PUT-Motorsport/PUTM_EV_Dashboard_2021/hardware/Wizualizacja.JPG

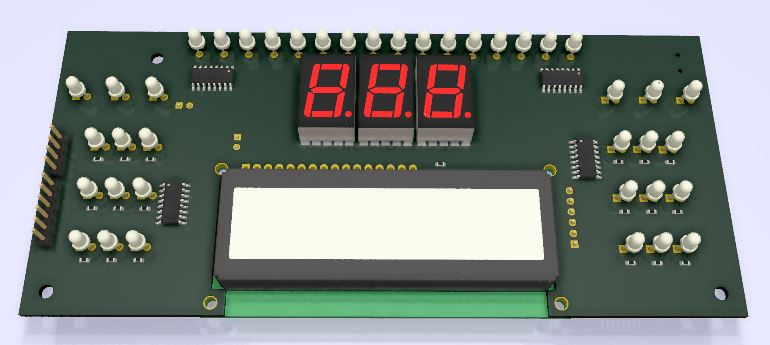
hardware/Wizualizacja.JPG
