PUT-Motorsport/PUTM_EV_Dashboard_2021/hardware/Display2.STEP

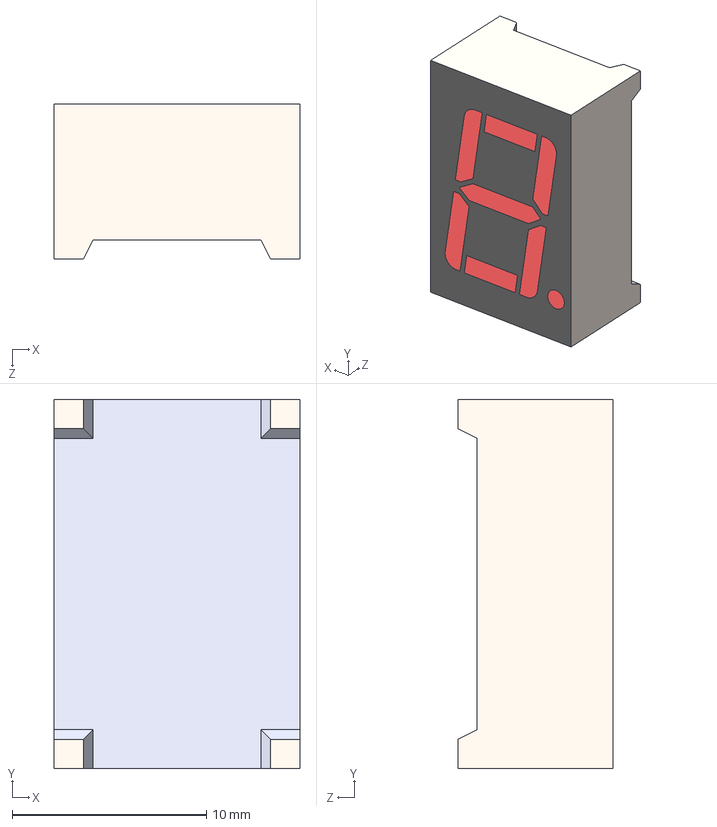
[picture p2: CAD file, 2021-06-22]
hardware/Display2.STEP
12.7 x 19.0 x 8.00 mm
