PUT-Motorsport/PUTM_EV_Dashboard_2021/(list of files, cad)

Other CAD files:
hardware/Display.STEP
hardware/Display.SLDPRT
