PUT-Motorsport/PUTM_EV_Dashboard_2021/hardware/dash_hw.kicad_pcb

## KiCad design hardware/dash_hw.kicad_pcb (2021-06-22)

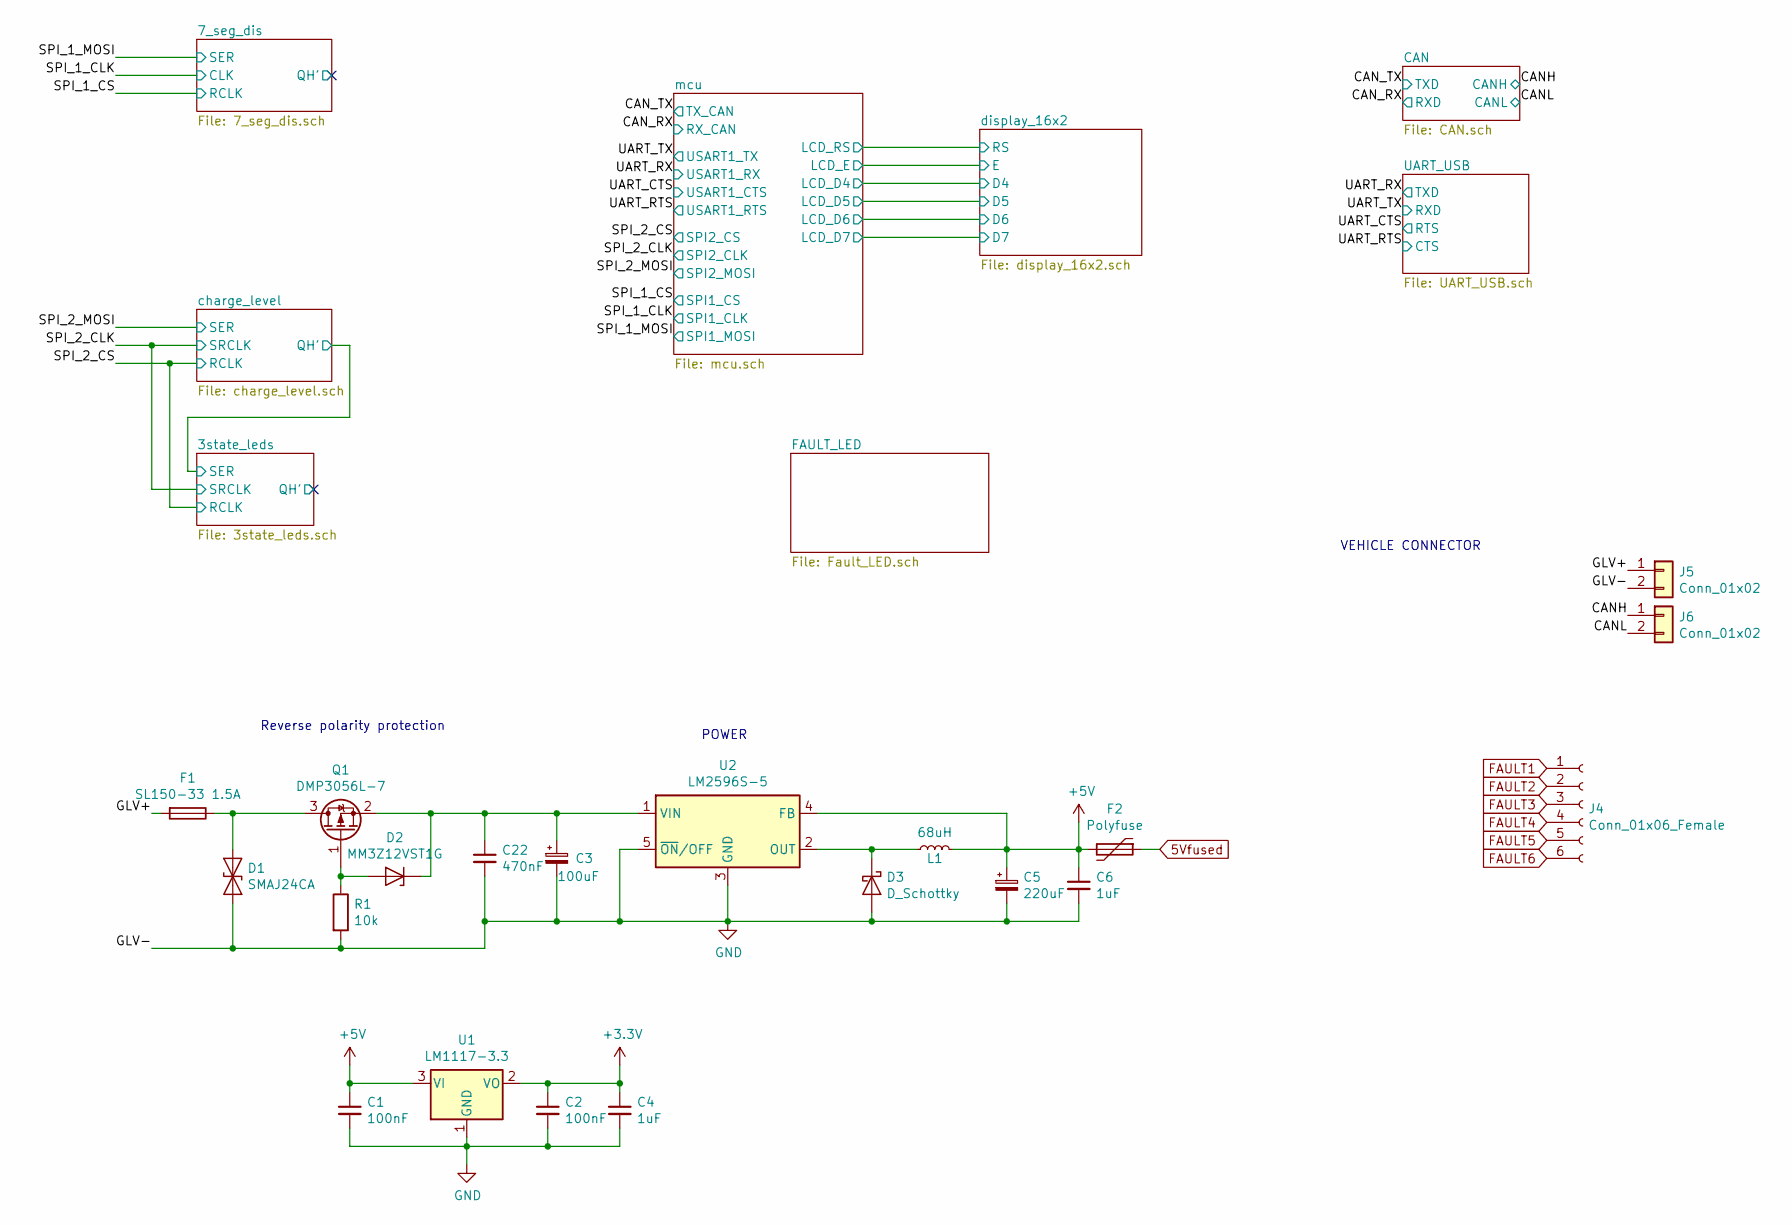
[picture p3: schematic dash_hw.sch, PUTM_EV_Dashboard_2021]

Parts:
C1, C2: 100nF; C_0603_1608Metric
C3: 100uF; CP_Radial_D6.3mm_P2.50mm
C4, C6: 1uF; C_0603_1608Metric
C5: 220uF; CP_Radial_D6.3mm_P2.50mm
C22: 470nF; C_1206_3216Metric
D1: SMAJ24CA; D_SMA
D2: MM3Z12VST1G; D_SOD-323
D3: D_Schottky; D_SMB
F1: SL150-33 1.5A; Fuse_2920_7451Metric
F2: Polyfuse; Fuse_2010_5025Metric
J4: Conn_01x06_Female; PinHeader_1x06_P2.54mm_Vertical
J5, J6: Conn_01x02; PinHeader_1x02_P2.54mm_Vertical
L1: 68uH; L_10.4x10.4_H4.8
Q1: DMP3056L-7; SOT-23
R1: 10k; R_0603_1608Metric
U1: LM1117-3.3; SOT-223-3_TabPin2
U2: LM2596S-5; TO-263-5_TabPin3

Connections:
5Vfused: F2.1; also elsewhere on the board
+3V3: C2.1, C4.1, U1.2 (VO); also elsewhere on the board
+5V: C1.1, C5.1, C6.1, F2.2, L1.2, U1.3 (VI), U2.4 (FB); also elsewhere on the board
/CANH: J6.1; also elsewhere on the board
/CANL: J6.2; also elsewhere on the board
/GLV+: F1.2, J5.1
FAULT1: J4.1; also elsewhere on the board
FAULT2: J4.2; also elsewhere on the board
FAULT3: J4.3; also elsewhere on the board
FAULT4: J4.4; also elsewhere on the board
FAULT5: J4.5; also elsewhere on the board
FAULT6: J4.6; also elsewhere on the board
GND: C1.2, C2.2, C3.2, C4.2, C5.2, C6.2, C22.2, D1.2 (A2), D3.2 (A), J5.2, R1.2, U1.1 (GND), U2.3 (GND), U2.5 (~ON~/OFF); also elsewhere on the board
unnamed: C3.1, C22.1, D2.1 (K), Q1.2 (S), U2.1 (VIN)
unnamed: D1.1 (A1), F1.1, Q1.3 (D)
unnamed: D2.2 (A), Q1.1 (G), R1.1
unnamed: D3.1 (K), L1.1, U2.2 (OUT)

Notes on the sheet:
POWER
Reverse polarity protection
VEHICLE CONNECTOR

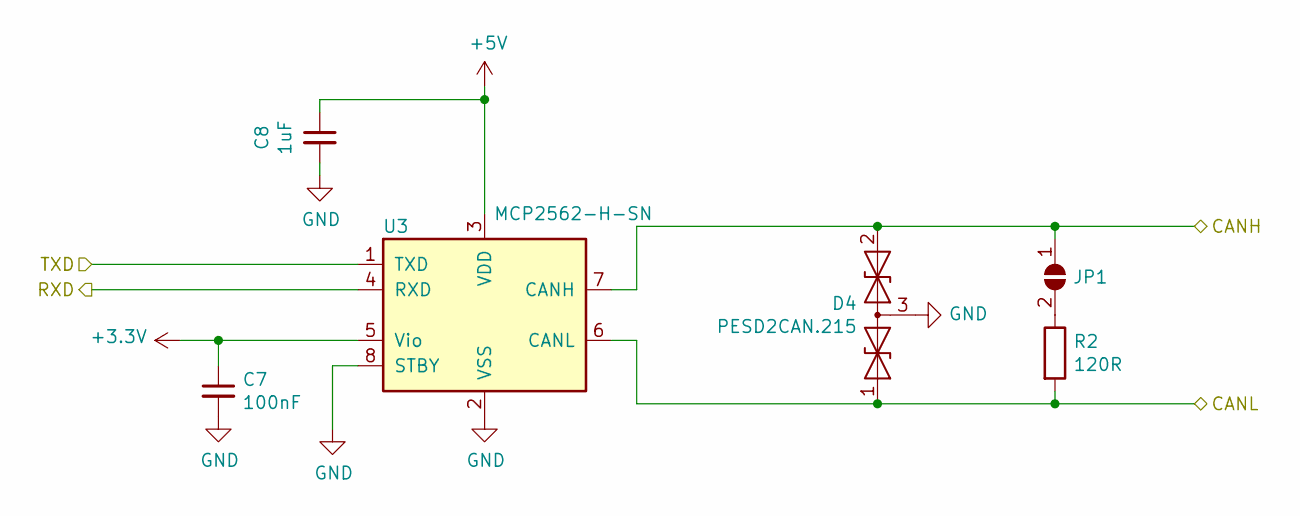
[picture p4: schematic CAN.sch, PUTM_EV_Dashboard_2021]

Parts:
C7: 100nF; C_0603_1608Metric
C8: 1uF; C_0603_1608Metric
D4: PESD2CAN.215; SOT-23
JP1: a; SolderJumper-2_P1.3mm_Open_TrianglePad1.0x1.5mm
R2: 120R; R_0603_1608Metric
U3: MCP2562-H-SN; SOIC-8_3.9x4.9mm_P1.27mm

Connections:
+3V3: C7.1, U3.5 (Vio); also elsewhere on the board
+5V: C8.1, U3.3 (VDD); also elsewhere on the board
/CANH: D4.2 (A2), JP1.1 (A), U3.7 (CANH); also elsewhere on the board
/CANL: D4.1 (A1), R2.2, U3.6 (CANL); also elsewhere on the board
/CAN_RX: U3.4 (RXD); also elsewhere on the board
/CAN_TX: U3.1 (TXD); also elsewhere on the board
GND: C7.2, C8.2, D4.3 (common), U3.2 (VSS), U3.8 (STBY); also elsewhere on the board
unnamed: JP1.2 (B), R2.1

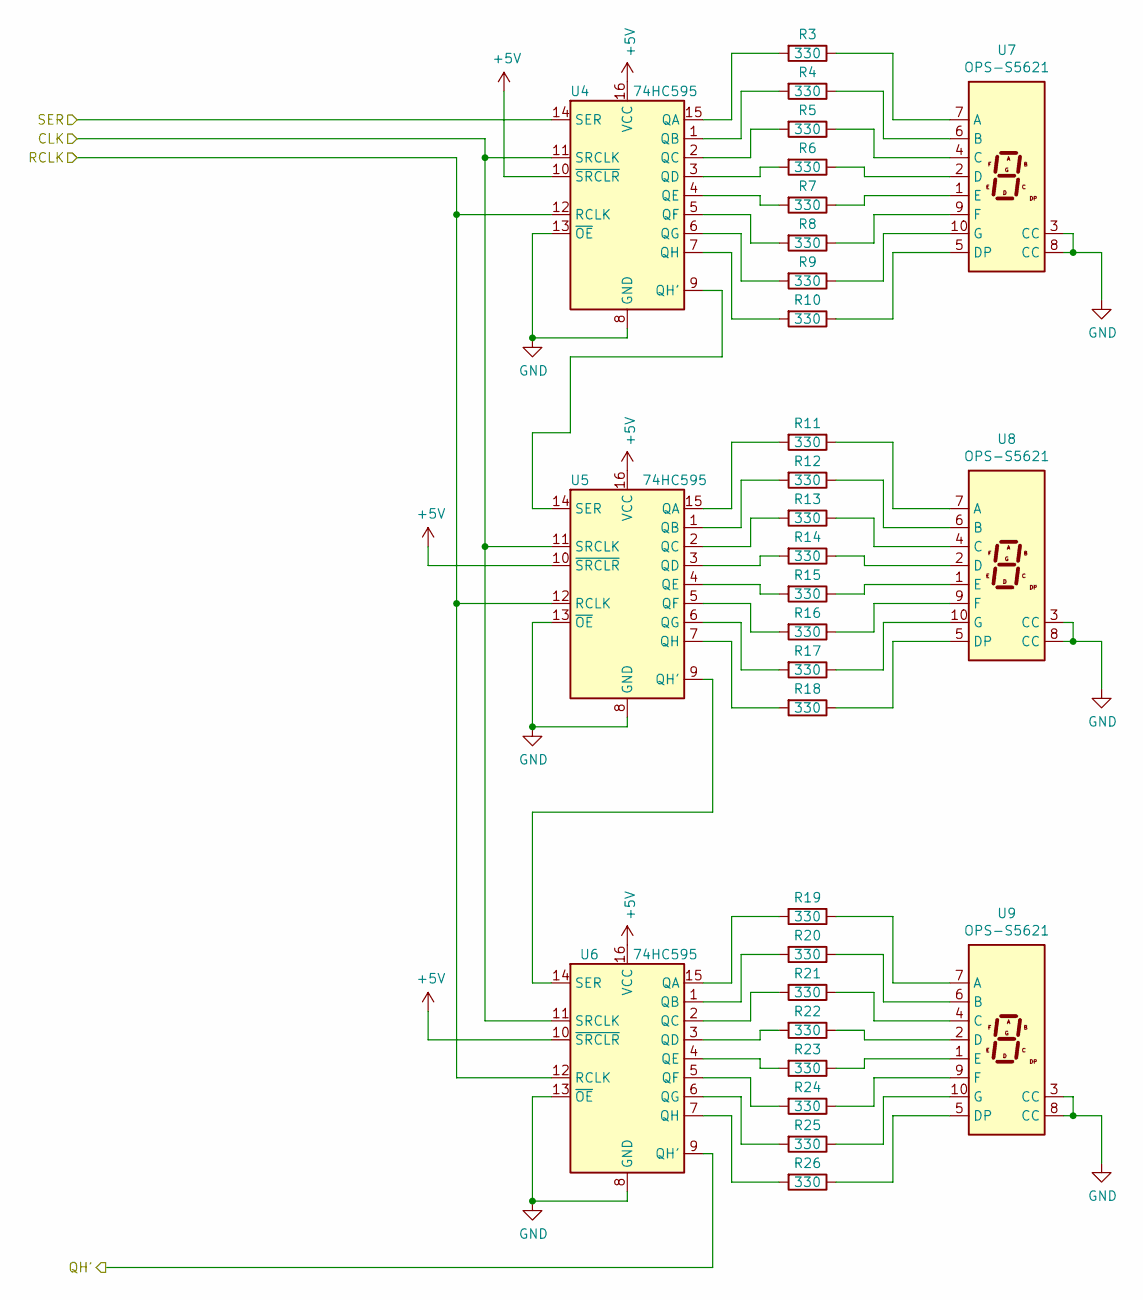
[picture p5: schematic 7_seg_dis.sch, PUTM_EV_Dashboard_2021]

Parts:
R3, R4, R5, R6, R7, R8, R9, R10, R11, R12, R13, R14, R15, R16, R17, R18, R19, R20, R21, R22, R23, R24, R25, R26: 330; R_0603_1608Metric
U4, U5, U6: 74HC595; SOIC-16_3.9x9.9mm_P1.27mm
U7, U8, U9: OPS-S5621; 0.56” Case Mold Type LED Display

Connections:
+5V: U4.10 (~SRCLR), U4.16 (VCC), U5.10 (~SRCLR), U5.16 (VCC), U6.10 (~SRCLR), U6.16 (VCC); also elsewhere on the board
/7_seg_dis/QH': U6.9 (QH')
/SPI_1_CLK: U4.11 (SRCLK), U5.11 (SRCLK), U6.11 (SRCLK); also elsewhere on the board
/SPI_1_CS: U4.12 (RCLK), U5.12 (RCLK), U6.12 (RCLK); also elsewhere on the board
/SPI_1_MOSI: U4.14 (SER); also elsewhere on the board
GND: U4.8 (GND), U4.13 (~OE), U5.8 (GND), U5.13 (~OE), U6.8 (GND), U6.13 (~OE), U7.3 (CC), U7.8 (CC), U8.3 (CC), U8.8 (CC), U9.3 (CC), U9.8 (CC); also elsewhere on the board
unnamed: R3.1, U7.7 (A)
unnamed: R3.2, U4.15 (QA)
unnamed: R4.1, U7.6 (B)
unnamed: R4.2, U4.1 (QB)
unnamed: R5.1, U7.4 (C)
unnamed: R5.2, U4.2 (QC)
unnamed: R6.1, U7.2 (D)
unnamed: R6.2, U4.3 (QD)
unnamed: R7.1, U7.1 (E)
unnamed: R7.2, U4.4 (QE)
unnamed: R8.1, U7.9 (F)
unnamed: R8.2, U4.5 (QF)
unnamed: R9.1, U7.10 (G)
unnamed: R9.2, U4.6 (QG)
unnamed: R10.1, U7.5 (DP)
unnamed: R10.2, U4.7 (QH)
unnamed: R11.1, U8.7 (A)
unnamed: R11.2, U5.15 (QA)
unnamed: R12.1, U8.6 (B)
unnamed: R12.2, U5.1 (QB)
unnamed: R13.1, U8.4 (C)
unnamed: R13.2, U5.2 (QC)
unnamed: R14.1, U8.2 (D)
unnamed: R14.2, U5.3 (QD)
unnamed: R15.1, U8.1 (E)
unnamed: R15.2, U5.4 (QE)
unnamed: R16.1, U8.9 (F)
unnamed: R16.2, U5.5 (QF)
unnamed: R17.1, U8.10 (G)
unnamed: R17.2, U5.6 (QG)
unnamed: R18.1, U8.5 (DP)
unnamed: R18.2, U5.7 (QH)
unnamed: R19.1, U9.7 (A)
unnamed: R19.2, U6.15 (QA)
unnamed: R20.1, U9.6 (B)
unnamed: R20.2, U6.1 (QB)
unnamed: R21.1, U9.4 (C)
unnamed: R21.2, U6.2 (QC)
unnamed: R22.1, U9.2 (D)
unnamed: R22.2, U6.3 (QD)
unnamed: R23.1, U9.1 (E)
unnamed: R23.2, U6.4 (QE)
unnamed: R24.1, U9.9 (F)
unnamed: R24.2, U6.5 (QF)
unnamed: R25.1, U9.10 (G)
unnamed: R25.2, U6.6 (QG)
unnamed: R26.1, U9.5 (DP)
unnamed: R26.2, U6.7 (QH)
unnamed: U4.9 (QH'), U5.14 (SER)
unnamed: U5.9 (QH'), U6.14 (SER)

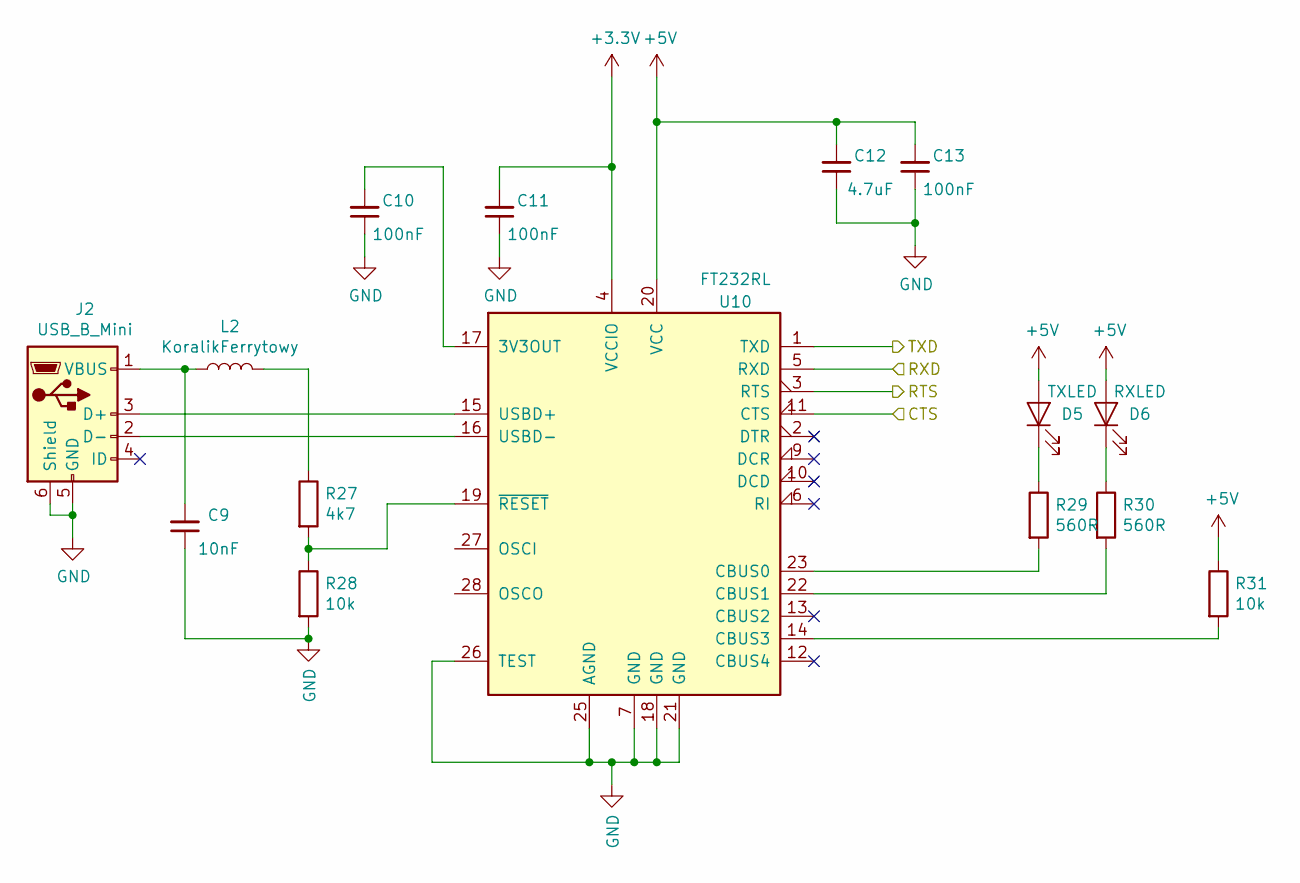
[picture p6: schematic UART_USB.sch, PUTM_EV_Dashboard_2021]

Parts:
C9: 10nF; C_0603_1608Metric
C10, C11, C13: 100nF; C_0603_1608Metric
C12: 4.7uF; C_0603_1608Metric
D5: TXLED; LED_0603_1608Metric
D6: RXLED; LED_0603_1608Metric
J2: USB_B_Mini; USB_Mini-B_Lumberg_2486_01_Horizontal
L2: KoralikFerrytowy; L_0603_1608Metric
R27: 4k7; R_0603_1608Metric
R28, R31: 10k; R_0603_1608Metric
R29, R30: 560R; R_0603_1608Metric
U10: FT232RL; SSOP-28_5.3x10.2mm_P0.65mm

Connections:
+3V3: C11.2, U10.4 (VCCIO); also elsewhere on the board
+5V: C12.2, C13.2, D5.2 (A), D6.2 (A), R31.1, U10.20 (VCC); also elsewhere on the board
/UART_CTS: U10.3 (RTS); also elsewhere on the board
/UART_RTS: U10.11 (CTS); also elsewhere on the board
/UART_RX: U10.1 (TXD); also elsewhere on the board
/UART_TX: U10.5 (RXD); also elsewhere on the board
GND: C9.1, C10.1, C11.1, C12.1, C13.1, J2.5 (GND), J2.6 (Shield), R28.2, U10.7 (GND), U10.18 (GND), U10.21 (GND), U10.25 (AGND), U10.26 (TEST); also elsewhere on the board
unnamed: C9.2, J2.1 (VBUS), L2.1
unnamed: C10.2, U10.17 (3V3OUT)
unnamed: D5.1 (K), R29.1
unnamed: D6.1 (K), R30.1
unnamed: J2.2 (D-), U10.16 (USBD-)
unnamed: J2.3 (D+), U10.15 (USBD+)
unnamed: L2.2, R27.1
unnamed: R27.2, R28.1, U10.19 (~RESET~)
unnamed: R29.2, U10.23 (CBUS0)
unnamed: R30.2, U10.22 (CBUS1)
unnamed: R31.2, U10.14 (CBUS3)

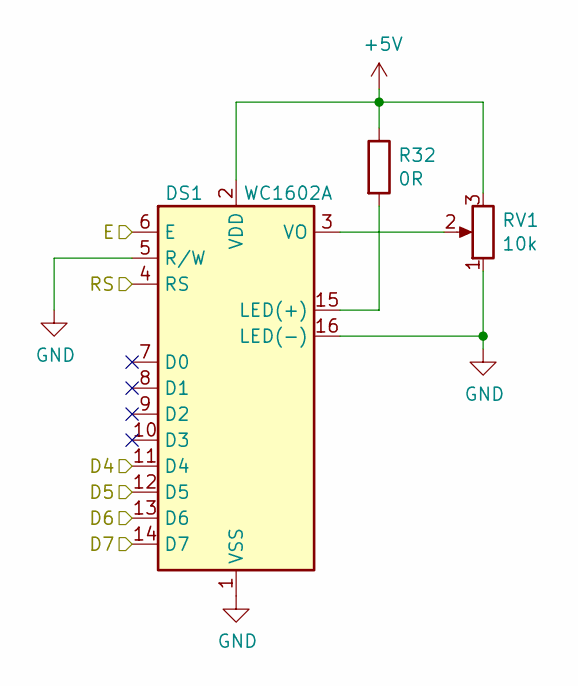
[picture p7: schematic display_16x2.sch, PUTM_EV_Dashboard_2021]

Parts:
DS1: WC1602A
R32: 0R; R_0603_1608Metric
RV1: 10k; Potentiometer_Vishay_TS53YJ_Vertical

Connections:
+5V: DS1.2 (VDD), R32.1, RV1.3; also elsewhere on the board
/display_16x2/D4: DS1.11 (D4); also elsewhere on the board
/display_16x2/D5: DS1.12 (D5); also elsewhere on the board
/display_16x2/D6: DS1.13 (D6); also elsewhere on the board
/display_16x2/D7: DS1.14 (D7); also elsewhere on the board
/display_16x2/E: DS1.6 (E); also elsewhere on the board
/mcu/LCD_RS: DS1.4 (RS); also elsewhere on the board
GND: DS1.1 (VSS), DS1.5 (R/W), DS1.16 (LED(-)), RV1.1; also elsewhere on the board
unnamed: DS1.3 (VO), RV1.2
unnamed: DS1.15 (LED(+)), R32.2

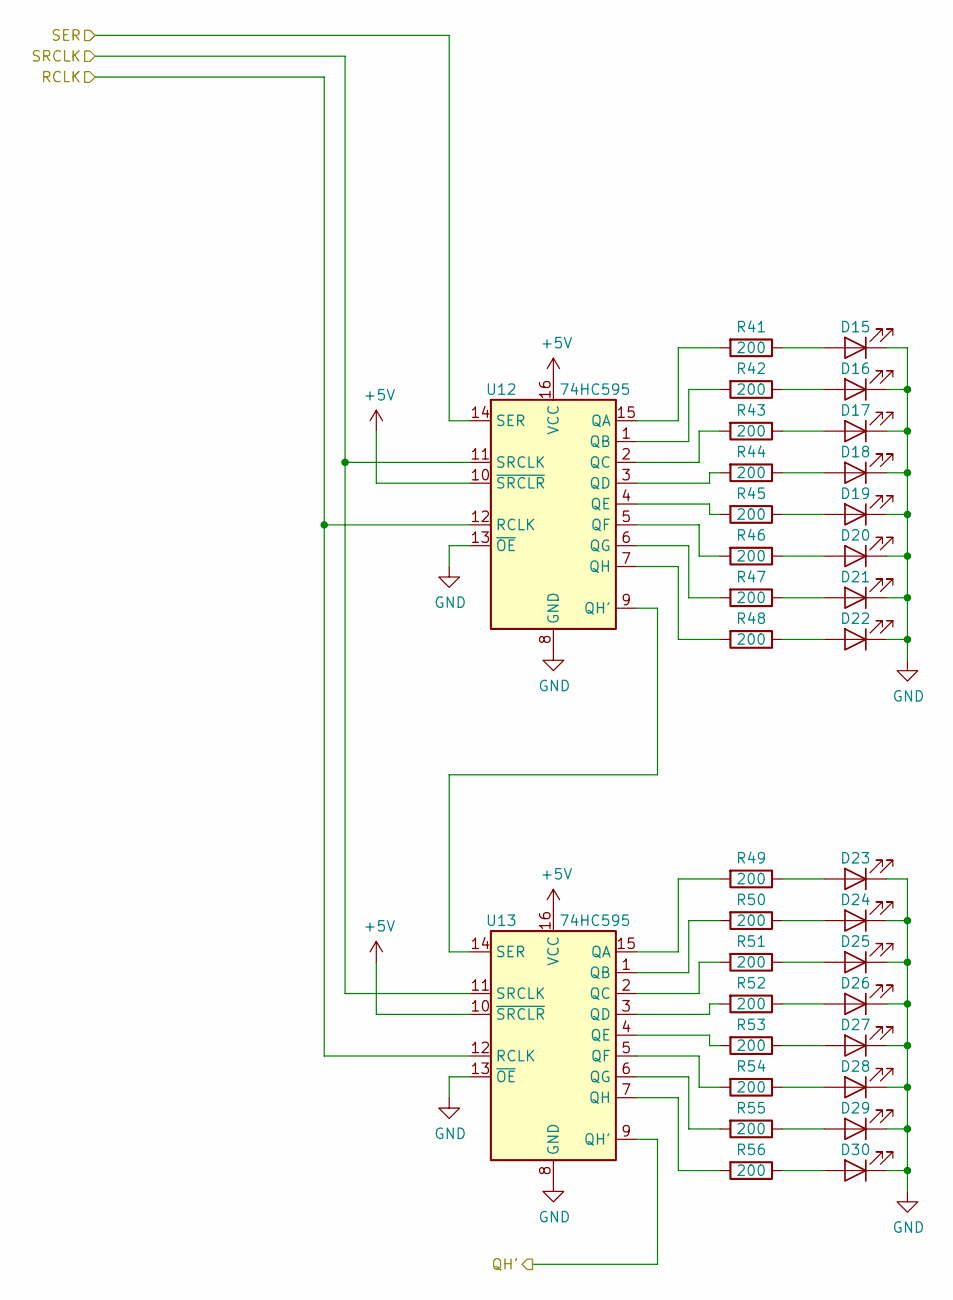
[picture p8: schematic charge_level.sch]

Parts:
D15, D16, D17, D18, D19, D20, D21, D22, D23, D24, D25, D26, D27, D28, D29, D30: LED; LED_D3.0mm_Clear
R41, R42, R43, R44, R45, R46, R47, R48, R49, R50, R51, R52, R53, R54, R55, R56: 200; R_0603_1608Metric
U12, U13: 74HC595; SOIC-16_3.9x9.9mm_P1.27mm

Connections:
+5V: U12.10 (~SRCLR), U12.16 (VCC), U13.10 (~SRCLR), U13.16 (VCC); also elsewhere on the board
/SPI_2_CLK: U12.11 (SRCLK), U13.11 (SRCLK); also elsewhere on the board
/SPI_2_CS: U12.12 (RCLK), U13.12 (RCLK); also elsewhere on the board
/SPI_2_MOSI: U12.14 (SER); also elsewhere on the board
/charge_level/QH': U13.9 (QH'); also elsewhere on the board
GND: D15.1 (K), D16.1 (K), D17.1 (K), D18.1 (K), D19.1 (K), D20.1 (K), D21.1 (K), D22.1 (K), D23.1 (K), D24.1 (K), D25.1 (K), D26.1 (K), D27.1 (K), D28.1 (K), D29.1 (K), D30.1 (K), U12.8 (GND), U12.13 (~OE), U13.8 (GND), U13.13 (~OE); also elsewhere on the board
unnamed: D15.2 (A), R41.1
unnamed: D16.2 (A), R42.1
unnamed: D17.2 (A), R43.1
unnamed: D18.2 (A), R44.1
unnamed: D19.2 (A), R45.1
unnamed: D20.2 (A), R46.1
unnamed: D21.2 (A), R47.1
unnamed: D22.2 (A), R48.1
unnamed: D23.2 (A), R49.1
unnamed: D24.2 (A), R50.1
unnamed: D25.2 (A), R51.1
unnamed: D26.2 (A), R52.1
unnamed: D27.2 (A), R53.1
unnamed: D28.2 (A), R54.1
unnamed: D29.2 (A), R55.1
unnamed: D30.2 (A), R56.1
unnamed: R41.2, U12.15 (QA)
unnamed: R42.2, U12.1 (QB)
unnamed: R43.2, U12.2 (QC)
unnamed: R44.2, U12.3 (QD)
unnamed: R45.2, U12.4 (QE)
unnamed: R46.2, U12.5 (QF)
unnamed: R47.2, U12.6 (QG)
unnamed: R48.2, U12.7 (QH)
unnamed: R49.2, U13.15 (QA)
unnamed: R50.2, U13.1 (QB)
unnamed: R51.2, U13.2 (QC)
unnamed: R52.2, U13.3 (QD)
unnamed: R53.2, U13.4 (QE)
unnamed: R54.2, U13.5 (QF)
unnamed: R55.2, U13.6 (QG)
unnamed: R56.2, U13.7 (QH)
unnamed: U12.9 (QH'), U13.14 (SER)

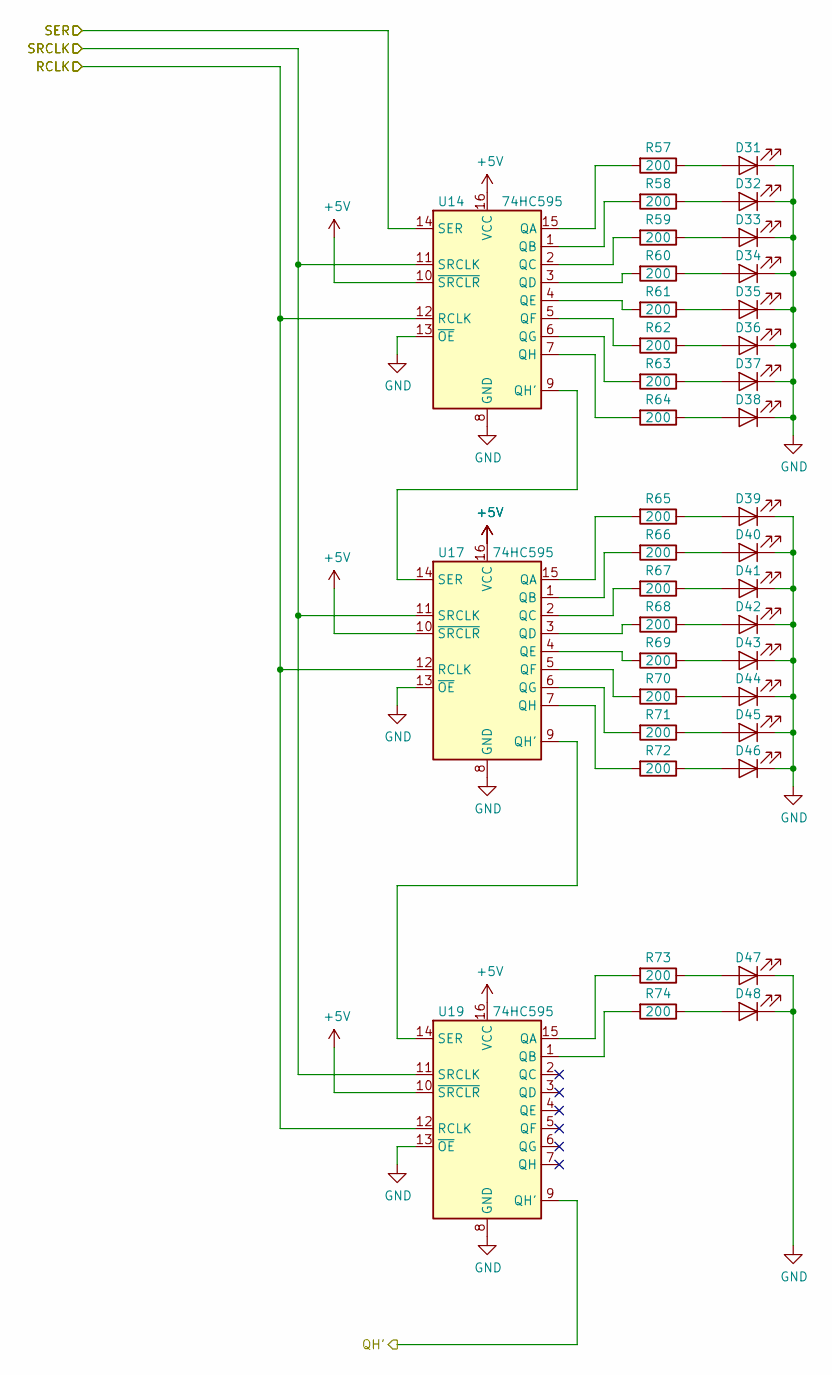
[picture p9: schematic 3state_leds.sch, PUTM_EV_Dashboard_2021]

Parts:
D31, D32, D33, D34, D35, D36, D37, D38, D39, D40, D41, D42, D43, D44, D45, D46, D47, D48: LED; LED_D3.0mm_Clear
R57, R58, R59, R60, R61, R62, R63, R64, R65, R66, R67, R68, R69, R70, R71, R72, R73, R74: 200; R_0603_1608Metric
U14, U17, U19: 74HC595; SOIC-16_3.9x9.9mm_P1.27mm

Connections:
+5V: U14.10 (~SRCLR), U14.16 (VCC), U17.10 (~SRCLR), U17.16 (VCC), U19.10 (~SRCLR), U19.16 (VCC); also elsewhere on the board
/3state_leds/QH': U19.9 (QH')
/SPI_2_CLK: U14.11 (SRCLK), U17.11 (SRCLK), U19.11 (SRCLK); also elsewhere on the board
/SPI_2_CS: U14.12 (RCLK), U17.12 (RCLK), U19.12 (RCLK); also elsewhere on the board
/charge_level/QH': U14.14 (SER); also elsewhere on the board
GND: D31.1 (K), D32.1 (K), D33.1 (K), D34.1 (K), D35.1 (K), D36.1 (K), D37.1 (K), D38.1 (K), D39.1 (K), D40.1 (K), D41.1 (K), D42.1 (K), D43.1 (K), D44.1 (K), D45.1 (K), D46.1 (K), D47.1 (K), D48.1 (K), U14.8 (GND), U14.13 (~OE), U17.8 (GND), U17.13 (~OE), U19.8 (GND), U19.13 (~OE); also elsewhere on the board
unnamed: D31.2 (A), R57.1
unnamed: D32.2 (A), R58.1
unnamed: D33.2 (A), R59.1
unnamed: D34.2 (A), R60.1
unnamed: D35.2 (A), R61.1
unnamed: D36.2 (A), R62.1
unnamed: D37.2 (A), R63.1
unnamed: D38.2 (A), R64.1
unnamed: D39.2 (A), R65.1
unnamed: D40.2 (A), R66.1
unnamed: D41.2 (A), R67.1
unnamed: D42.2 (A), R68.1
unnamed: D43.2 (A), R69.1
unnamed: D44.2 (A), R70.1
unnamed: D45.2 (A), R71.1
unnamed: D46.2 (A), R72.1
unnamed: D47.2 (A), R73.1
unnamed: D48.2 (A), R74.1
unnamed: R57.2, U14.15 (QA)
unnamed: R58.2, U14.1 (QB)
unnamed: R59.2, U14.2 (QC)
unnamed: R60.2, U14.3 (QD)
unnamed: R61.2, U14.4 (QE)
unnamed: R62.2, U14.5 (QF)
unnamed: R63.2, U14.6 (QG)
unnamed: R64.2, U14.7 (QH)
unnamed: R65.2, U17.15 (QA)
unnamed: R66.2, U17.1 (QB)
unnamed: R67.2, U17.2 (QC)
unnamed: R68.2, U17.3 (QD)
unnamed: R69.2, U17.4 (QE)
unnamed: R70.2, U17.5 (QF)
unnamed: R71.2, U17.6 (QG)
unnamed: R72.2, U17.7 (QH)
unnamed: R73.2, U19.15 (QA)
unnamed: R74.2, U19.1 (QB)
unnamed: U14.9 (QH'), U17.14 (SER)
unnamed: U17.9 (QH'), U19.14 (SER)

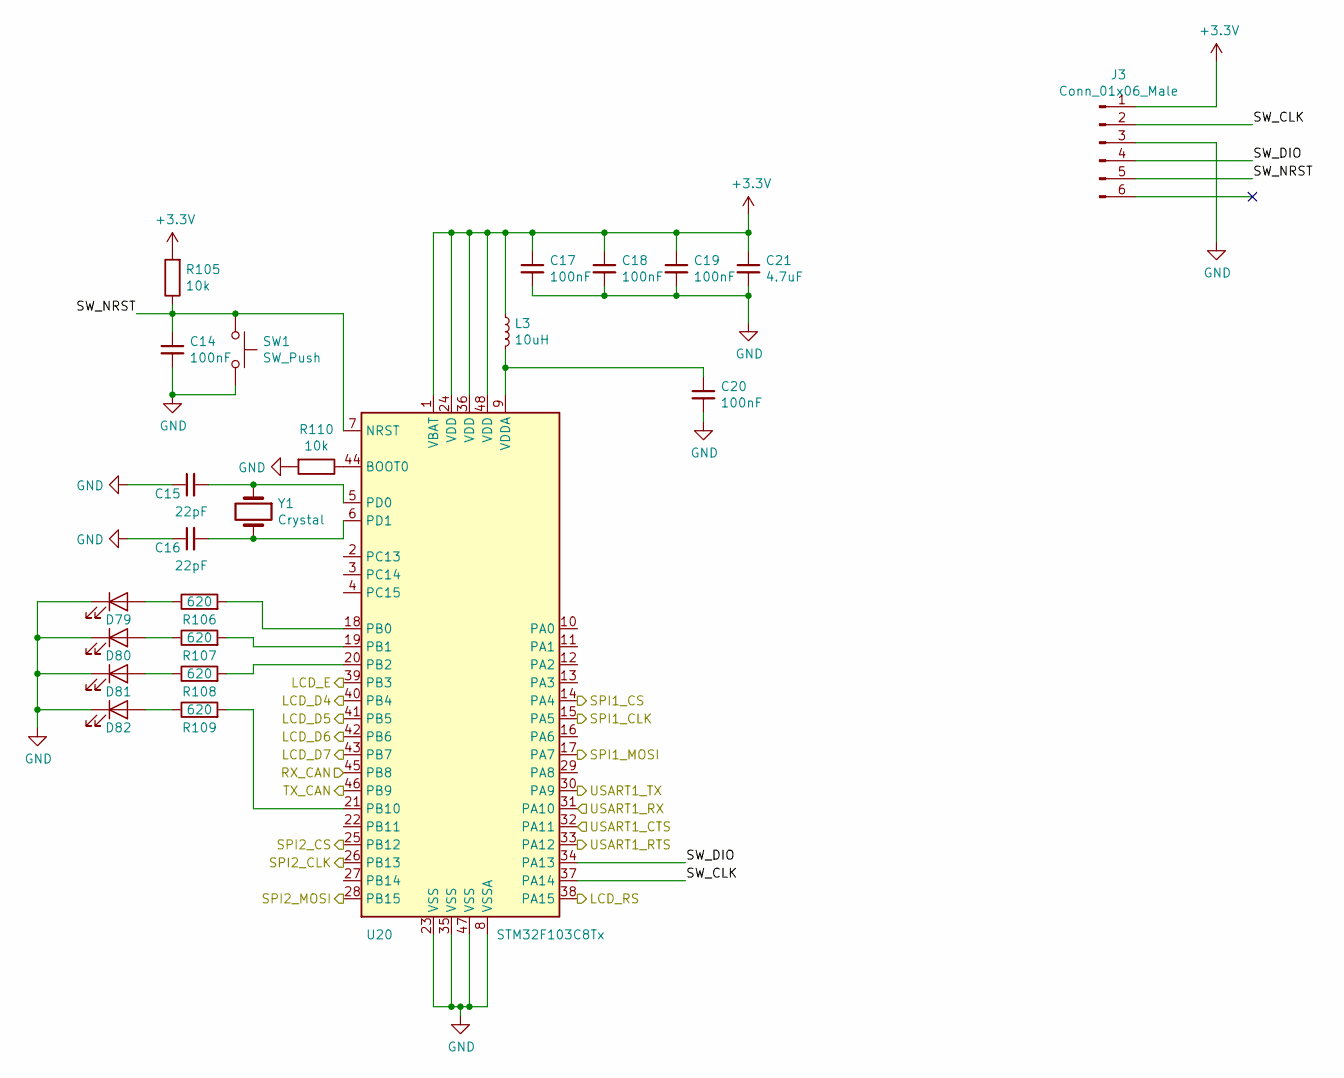
[picture p10: schematic mcu.sch]

Parts:
C14, C17, C18, C19, C20: 100nF; C_0603_1608Metric
C15, C16: 22pF; C_0603_1608Metric
C21: 4.7uF; C_0603_1608Metric
D79, D80, D81, D82: LED; LED_0603_1608Metric
J3: Conn_01x06_Male; PinHeader_1x06_P2.54mm_Vertical
L3: 10uH; L_0603_1608Metric
R105, R110: 10k; R_0603_1608Metric
R106, R107, R108, R109: 620; R_0603_1608Metric
SW1: SW_Push; SW_Push_1P1T_NO_6x6mm_H9.5mm
U20: STM32F103C8Tx; LQFP-48_7x7mm_P0.5mm
Y1: Crystal; Crystal_SMD_HC49-SD

Connections:
+3V3: C17.1, C18.1, C19.1, C21.1, J3.1, L3.1, R105.2, U20.1 (VBAT), U20.24 (VDD), U20.36 (VDD), U20.48 (VDD); also elsewhere on the board
/CAN_RX: U20.45 (PB8); also elsewhere on the board
/CAN_TX: U20.46 (PB9); also elsewhere on the board
/SPI_1_CLK: U20.15 (PA5); also elsewhere on the board
/SPI_1_CS: U20.14 (PA4); also elsewhere on the board
/SPI_1_MOSI: U20.17 (PA7); also elsewhere on the board
/SPI_2_CLK: U20.26 (PB13); also elsewhere on the board
/SPI_2_CS: U20.25 (PB12); also elsewhere on the board
/SPI_2_MOSI: U20.28 (PB15); also elsewhere on the board
/UART_CTS: U20.32 (PA11); also elsewhere on the board
/UART_RTS: U20.33 (PA12); also elsewhere on the board
/UART_RX: U20.31 (PA10); also elsewhere on the board
/UART_TX: U20.30 (PA9); also elsewhere on the board
/display_16x2/D4: U20.40 (PB4); also elsewhere on the board
/display_16x2/D5: U20.41 (PB5); also elsewhere on the board
/display_16x2/D6: U20.42 (PB6); also elsewhere on the board
/display_16x2/D7: U20.43 (PB7); also elsewhere on the board
/display_16x2/E: U20.39 (PB3); also elsewhere on the board
/mcu/LCD_RS: U20.38 (PA15); also elsewhere on the board
/mcu/SW_CLK: J3.2, U20.37 (PA14)
/mcu/SW_DIO: J3.4, U20.34 (PA13)
/mcu/SW_NRST: C14.1, J3.5, R105.1, SW1.1, U20.7 (NRST)
GND: C14.2, C15.1, C16.1, C17.2, C18.2, C19.2, C20.2, C21.2, D79.1 (K), D80.1 (K), D81.1 (K), D82.1 (K), J3.3, R110.2, SW1.2, U20.8 (VSSA), U20.23 (VSS), U20.35 (VSS), U20.47 (VSS); also elsewhere on the board
unnamed: C15.2, U20.5 (PD0), Y1.1
unnamed: C16.2, U20.6 (PD1), Y1.2
unnamed: C20.1, L3.2, U20.9 (VDDA)
unnamed: D79.2 (A), R106.1
unnamed: D80.2 (A), R107.1
unnamed: D81.2 (A), R108.1
unnamed: D82.2 (A), R109.1
unnamed: R106.2, U20.18 (PB0)
unnamed: R107.2, U20.19 (PB1)
unnamed: R108.2, U20.20 (PB2)
unnamed: R109.2, U20.21 (PB10)
unnamed: R110.1, U20.44 (BOOT0)

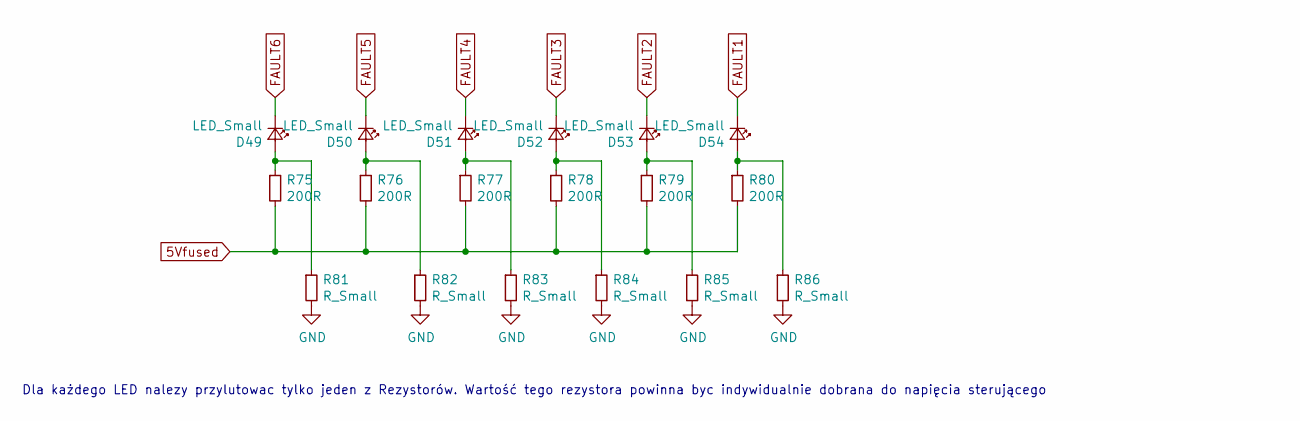
[picture p11: schematic Fault_LED.sch]

Parts:
D49, D50, D51, D52, D53, D54: LED_Small; LED_D3.0mm_Clear
R75, R76, R77, R78, R79, R80: 200R; C_0603_1608Metric
R81, R82, R83, R84, R85, R86: R_Small; C_0603_1608Metric

Connections:
5Vfused: R75.2, R76.2, R77.2, R78.2, R79.2, R80.2; also elsewhere on the board
FAULT1: D54.1 (K); also elsewhere on the board
FAULT2: D53.1 (K); also elsewhere on the board
FAULT3: D52.1 (K); also elsewhere on the board
FAULT4: D51.1 (K); also elsewhere on the board
FAULT5: D50.1 (K); also elsewhere on the board
FAULT6: D49.1 (K); also elsewhere on the board
GND: R81.2, R82.2, R83.2, R84.2, R85.2, R86.2; also elsewhere on the board
unnamed: D49.2 (A), R75.1, R81.1
unnamed: D50.2 (A), R76.1, R82.1
unnamed: D51.2 (A), R77.1, R83.1
unnamed: D52.2 (A), R78.1, R84.1
unnamed: D53.2 (A), R79.1, R85.1
unnamed: D54.2 (A), R80.1, R86.1

Notes on the sheet:
Dla każdego LED nalezy przylutowac tylko jeden z Rezystorów. Wartość tego rezystora powinna byc indywidualnie dobrana do napięcia sterującego

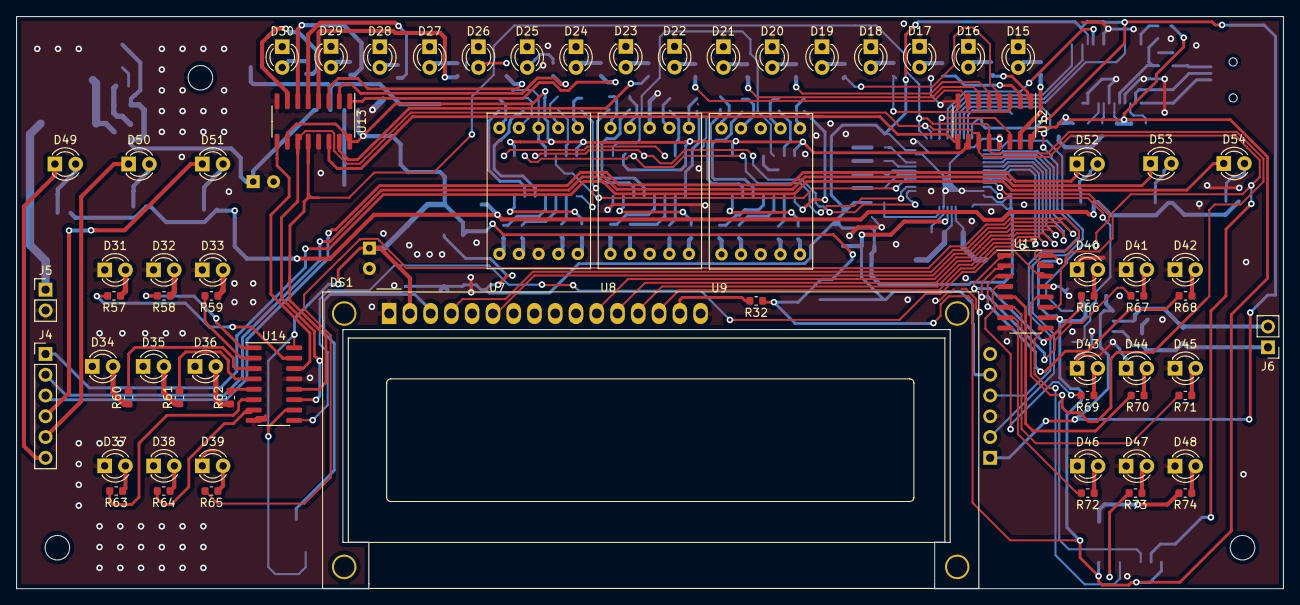
[picture p12: board dash_hw.kicad_pcb from above]

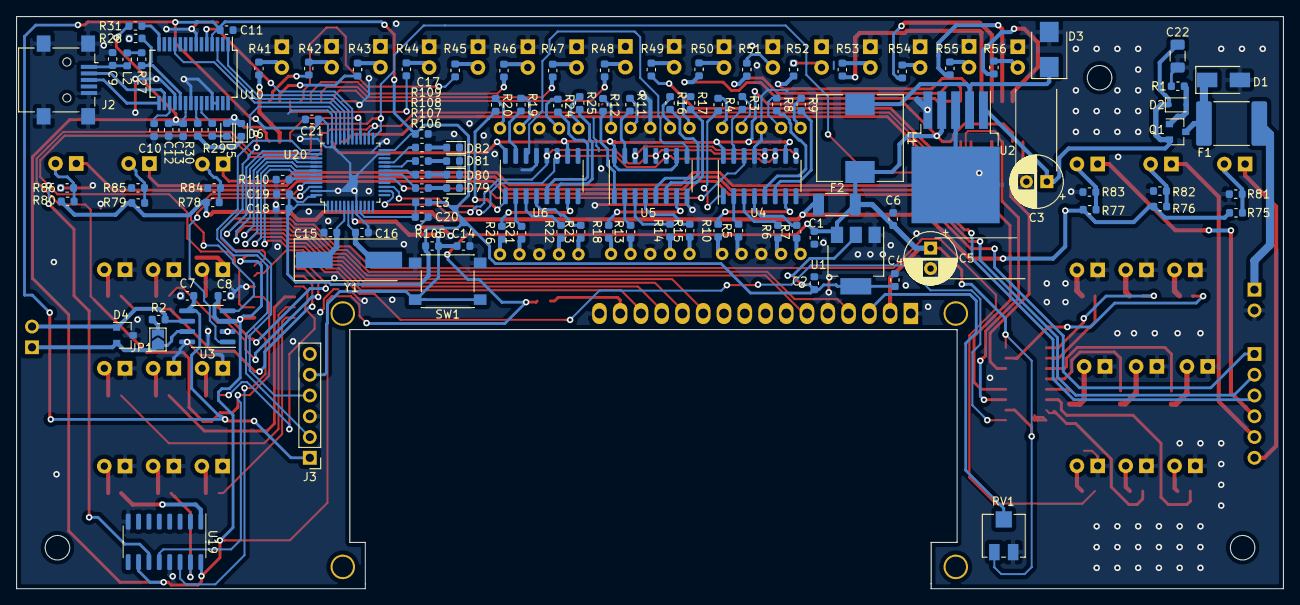
[picture p13: board dash_hw.kicad_pcb from below]

Board: 2 copper layers, 155.0 x 70.0 mm, 188 parts (118 on the bottom side), 192 nets.
