PUT-Motorsport/PUTM_EV_Dashboard_2021/PUTM_EV_Dashboard_2021_soft/Core/Src/main.c

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
/* Includes ------------------------------------------------------------------*/
#include "main.h"

/* USER CODE BEGIN Includes */
#include <utilities.h>
#include <lcd_driver.h>
/* USER CODE END Includes */

ADC_HandleTypeDef hadc1;

CAN_HandleTypeDef hcan;

SPI_HandleTypeDef hspi1;
SPI_HandleTypeDef hspi2;
DMA_HandleTypeDef hdma_spi1_tx;
DMA_HandleTypeDef hdma_spi2_tx;

TIM_HandleTypeDef htim2;
TIM_HandleTypeDef htim3;

UART_HandleTypeDef huart1;

/* USER CODE BEGIN PV */
CAN_RxHeaderTypeDef RxHeader;
uint8_t RxData[8];

CAN_FilterTypeDef sFilterConfig;

uint8_t carSpeed;

float lvVoltage;
float lvTempAvg;
float lvTempMax;
uint8_t lvState;

uint8_t hvVoltage;
float hvTempAvg;
float hvTempMax;
uint8_t hvState;

float waterTemp1;
float waterTemp2;

uint8_t updateDisplays;
uint8_t speedOrHvPer;
uint32_t changeSegTimeStamp;
uint8_t error;

uint32_t ledArray1;
uint8_t ledArray2;
uint32_t segDisplayArray;

/* USER CODE END PV */

void SystemClock_Config(void);

static void MX_GPIO_Init(void);

static void MX_DMA_Init(void);

static void MX_CAN_Init(void);

static void MX_SPI1_Init(void);

static void MX_SPI2_Init(void);

static void MX_USART1_UART_Init(void);

static void MX_TIM2_Init(void);

static void MX_ADC1_Init(void);

static void MX_TIM3_Init(void);
/* USER CODE BEGIN 0 */
void My_CAN_init(void);

/* USER CODE END 0 */

/**
  * @brief  The application entry point.
  * @retval int
  */
int main(void) {
    /* MCU Configuration--------------------------------------------------------*/

    /* Reset of all peripherals, Initializes the Flash interface and the Systick. */
    HAL_Init();

    /* Configure the system clock */
    SystemClock_Config();

    /* Initialize all configured peripherals */
    MX_GPIO_Init();
    MX_DMA_Init();
    MX_CAN_Init();
    MX_SPI1_Init();
    MX_SPI2_Init();
    MX_USART1_UART_Init();
    MX_TIM2_Init();
    MX_ADC1_Init();
    MX_TIM3_Init();
    /* USER CODE BEGIN 2 */

    My_CAN_init();

    HAL_TIM_Base_Start_IT(&htim2);
    HAL_TIM_Base_Start_IT(&htim3);

    updateDisplays = 0;
    speedOrHvPer = 0;
    error = 0;
    ledArray1 = 0;


    lcdInit();
    lcdMoveCursor(0, 0);
    lcdWriteString("Hello");
    lcdMoveCursor(1, 2);
    lcdWriteString("Hey");
    changeSegTimeStamp = 100;
    speedOrHvPer = 1;
    /* USER CODE END 2 */

    /* Infinite loop */
    /* USER CODE BEGIN WHILE */
    while (1) {
        uint8_t status = 0;
        if (updateDisplays) {
#ifndef TEST
            // send data to LED
            status |= sendLed();

            // send data to 7seg displays
            status |= send7Seg();

            // send data to alfanum display
            status |= sendAlfaNum();
#else
            test();
#endif

            if (status != HAL_OK) {
                Error_Handler();
            }
            updateDisplays = 0;
        }

        if (status) {
            Error_Handler();
        }

        /* USER CODE END WHILE */

        /* USER CODE BEGIN 3 */
    }
    /* USER CODE END 3 */
}

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
/* USER CODE BEGIN 4 */
void My_CAN_init(void) {
    sFilterConfig.FilterBank = 0;
    sFilterConfig.FilterMode = CAN_FILTERMODE_IDMASK;
    sFilterConfig.FilterScale = CAN_FILTERSCALE_32BIT;
    //sFilterConfig.FilterIdHigh = 0x0A << 5;
    sFilterConfig.FilterIdHigh = 0x0000;
    sFilterConfig.FilterIdLow = 0x0000;
    //sFilterConfig.FilterMaskIdHigh = 0xFFFF << 5;
    sFilterConfig.FilterMaskIdHigh = 0x0000;
    sFilterConfig.FilterMaskIdLow = 0x0000;
    sFilterConfig.FilterFIFOAssignment = CAN_RX_FIFO0;
    sFilterConfig.FilterActivation = ENABLE;
    sFilterConfig.SlaveStartFilterBank = 14;

    if (HAL_CAN_ConfigFilter(&hcan, &sFilterConfig) != HAL_OK) {
        Error_Handler();
    }

    if (HAL_CAN_Start(&hcan) != HAL_OK) {
        Error_Handler();
    }

    if (HAL_CAN_ActivateNotification(&hcan, CAN_IT_RX_FIFO0_MSG_PENDING | CAN_IT_TX_MAILBOX_EMPTY) != HAL_OK) {
        Error_Handler();
    }
}


/* USER CODE END 4 */
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
