PUT-Motorsport/PUTM_EV_Dashboard_2021/PUTM_EV_Dashboard_2021_soft/PUTM_EV_Dashboard_2021_soft.ioc

Mcu.UserName=STM32F103C8Tx
PA0-WKUP.Signal=ADCx_IN0
PA10.Signal=USART1_RX
PA11.Signal=USART1_CTS
PA12.Signal=USART1_RTS
PA13.Signal=SYS_JTMS-SWDIO
PA14.Signal=SYS_JTCK-SWCLK
PA15.GPIO_Label=LCD_RS
PA15.Signal=GPIO_Output
PA4.GPIO_Label=SPI1_NSS
PA4.Signal=GPIO_Output
PA5.Signal=SPI1_SCK
PA6.Signal=SPI1_MISO
PA7.Signal=SPI1_MOSI
PA9.Signal=USART1_TX
PB12.GPIO_Label=SPI2_NSS
PB12.Signal=GPIO_Output
PB13.Signal=SPI2_SCK
PB14.Signal=SPI2_MISO
PB15.Signal=SPI2_MOSI
PB3.GPIO_Label=LCD_E
PB3.Signal=GPIO_Output
PB4.GPIO_Label=LCD_D4
PB4.Signal=GPIO_Output
PB5.GPIO_Label=LCD_D5
PB5.Signal=GPIO_Output
PB6.GPIO_Label=LCD_D6
PB6.Signal=GPIO_Output
PB7.GPIO_Label=LCD_D7
PB7.Signal=GPIO_Output
PB8.Signal=CAN_RX
PB9.Signal=CAN_TX
