PUT-Motorsport/PUTM_EV_Dashboard_2021/PUTM_EV_Dashboard_2021_soft/Core/Inc/main.h

#define SPI1_NSS_Pin GPIO_PIN_4
#define SPI1_NSS_GPIO_Port GPIOA
#define SPI2_NSS_Pin GPIO_PIN_12
#define SPI2_NSS_GPIO_Port GPIOB
#define LCD_RS_Pin GPIO_PIN_15
#define LCD_RS_GPIO_Port GPIOA
#define LCD_E_Pin GPIO_PIN_3
#define LCD_E_GPIO_Port GPIOB
#define LCD_D4_Pin GPIO_PIN_4
#define LCD_D4_GPIO_Port GPIOB
#define LCD_D5_Pin GPIO_PIN_5
#define LCD_D5_GPIO_Port GPIOB
#define LCD_D6_Pin GPIO_PIN_6
#define LCD_D6_GPIO_Port GPIOB
#define LCD_D7_Pin GPIO_PIN_7
#define LCD_D7_GPIO_Port GPIOB
