PUT-Motorsport/PUTM_EV_Dashboard_2021/PUTM_EV_Dashboard_2021_soft/Core/Inc/barriers.h

//
// Created by kwitnoncy on 31.03.2021.
//

#ifndef PUTM_EV_DASHBOARD_2021_SOFT_BARRIERS_H
#define PUTM_EV_DASHBOARD_2021_SOFT_BARRIERS_H

#define LV_VOLTAGE_ALARM    0
#define LV_VOLTAGE_LOW      1
#define LV_VOLTAGE_MID      2
#define LV_VOLTAGE_HIGH     3
#define LV_VOLTAGE_OFFSET   0

#define LV_TEMP_ALARM       0
#define LV_TEMP_LOW         1
#define LV_TEMP_MID         2
#define LV_TEMP_HIGH        2
#define LV_TEMP_OFFSET      2

#define HV_VOLTAGE_ALARM    0
#define HV_VOLTAGE_LOW      1
#define HV_VOLTAGE_MID      2
#define HV_VOLTAGE_HIGH     3
#define HV_VOLTAGE_OFFSET   3

#define HV_TEMP_ALARM       0
#define HV_TEMP_LOW         1
#define HV_TEMP_MID         2
#define HV_TEMP_HIGH        3
#define HV_TEMP_OFFSET      3

#define WATER_T_1_ALARM     0
#define WATER_T_1_LOW       1
#define WATER_T_1_MID       2
#define WATER_T_1_HIGH      3
#define WATER_T_1_OFFSET    3

#define WATER_T_2_ALARM     0
#define WATER_T_2_LOW       0
#define WATER_T_2_MID       0
#define WATER_T_2_HIGH      0
#define WATER_T_2_OFFSET    0

#define HV_BIG_VOL_OFFSET   0


#endif //PUTM_EV_DASHBOARD_2021_SOFT_BARRIERS_H
