PUT-Motorsport/PUTM_EV_Dashboard_2021/(commit log)

2020-11-28 kicad dash project
    [7_seg_dis.sch, CAN.sch, Diodes.sch, Power_suppy.sch, UART_USB.sch, dash_hw.kicad_pcb, dash_hw.sch, display_16x2.sch]
2020-12-07 reorganized schematic; added reverse polarity protection; start adding footprints
    [3state_leds.sch, 7_seg_dis.sch, CAN.sch, Power_suppy.sch, Rev.sch, UART_USB.sch, charge_level.sch, dash_hw.sch]
2020-12-19 footprints; library for 7seg; start pcb layout
    [3state_leds.sch, 7_seg_dis.sch, CAN.sch, Rev.sch, UART_USB.sch, charge_level.sch, dash_hw.sch, display_16x2.sch]
2021-01-10 remove double elements in 3state leds
    [3state_leds.sch, dash_hw.kicad_pcb]
2021-01-10 one more input capacitor
    [dash_hw.sch]
2021-04-21 Added LCD support Need testing and update (timer)
2021-04-21 Hardware update Approved
    [3state_leds.sch, 7_seg_dis.sch, CAN.sch, Display.SLDPRT, Display.STEP, Display2.STEP, Fault_LED.sch, Rev.sch]
2021-05-03 Updated hardware
    [dash_hw.kicad_pcb, dash_hw.sch]
2021-05-03 SMD elements labels layeout updated
    [dash_hw.kicad_pcb]
2021-05-24 LCD Disp driver
2021-05-26 added drivers and linker file
2021-05-30 Button handling
2021-06-25 disp update, hot fixes, offets, hv/speed
    [can_bus_protocol.h, common.h, main.c, utilities.c, utilities.h]
2021-06-28 7seg OK, LED are working
